IsaacNorris/new-stm32u3-203f-hardware/TODO.txt

add in pullups to the i2c logic.
remove all 1v8 logic and parts. 
add in resivour capacitors near the amplifier.

new stm32:
	https://www.digikey.com/en/products/detail/stmicroelectronics/STM32WB55CEU6/9919555
new dac:
	PCM5102a <- guaranteed works lol :)
	TAD5142
axeleromter:
	https://www.digikey.com.au/en/products/detail/stmicroelectronics/LSM6DSMTR/6192777
