IsaacNorris/new-stm32u3-203f-hardware/new-stm32u3-203f/new-stm32u3-203f.kicad_pcb

## KiCad design new-stm32u3-203f/new-stm32u3-203f.kicad_pcb (2026-02-23)

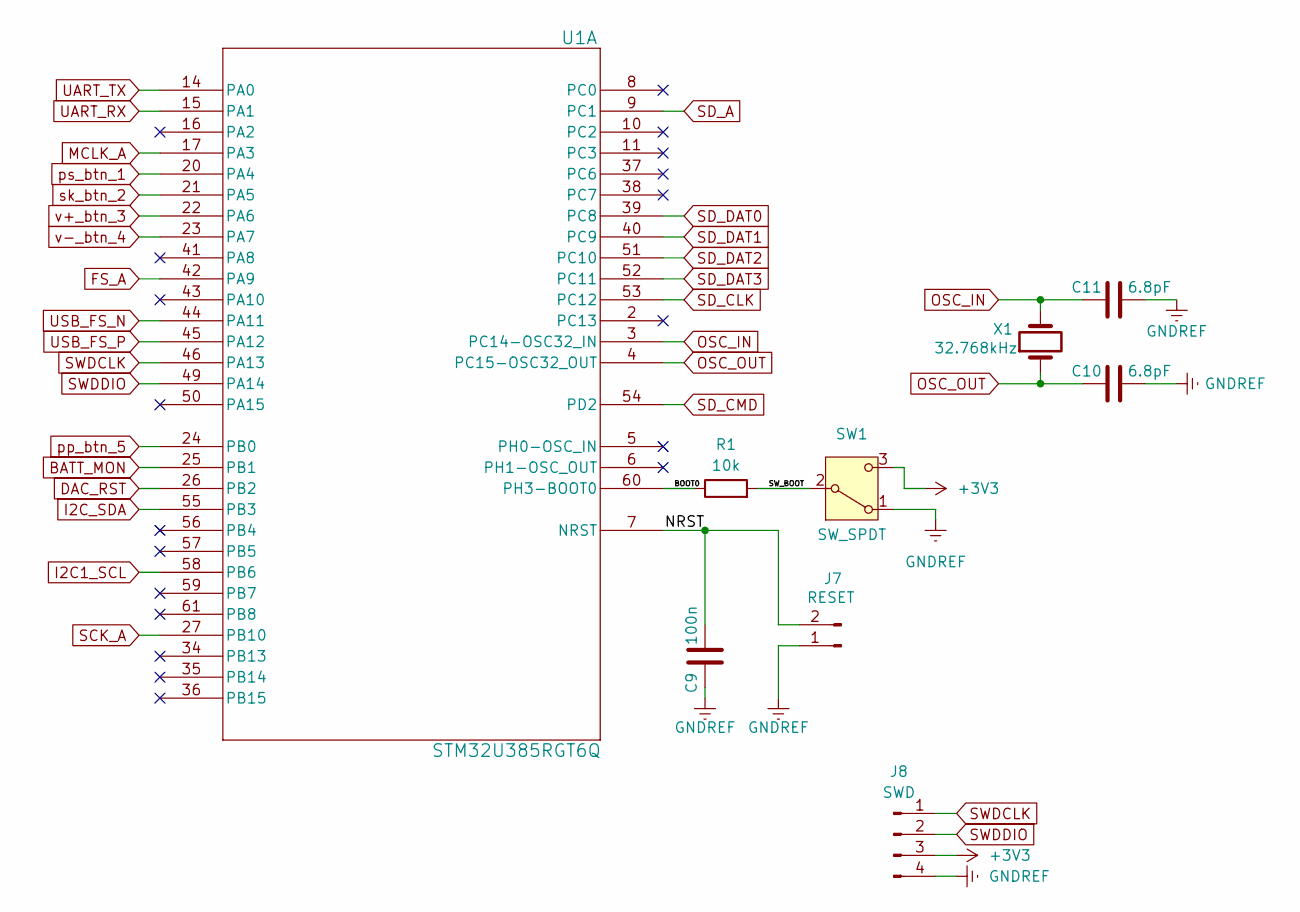
[picture p1: schematic new-stm32u3-203d-MCU_IO.kicad_sch]

Parts:
C9: 100n; C_0603_1608Metric
C10, C11: 6.8pF; C_0603_1608Metric
J7: RESET; PinHeader_1x02_P1.00mm_Vertical
J8: SWD; PinHeader_1x04_P2.54mm_Vertical
R1: 10k; R_0603_1608Metric
SW1: SW_SPDT; SW_CJS-1200TA
U1: STM32U385RGT6Q; LQFP-64_10x10mm_P0.5mm
X1: 32.768kHz; Crystal_SMD_3215-2Pin_3.2x1.5mm

Connections:
/MCU_IO/BOOT0: R1.1, U1.60 (PH3-BOOT0)
/MCU_IO/NRST: C9.2, J7.2, U1.7 (NRST)
/MCU_IO/SW_BOOT: R1.2, SW1.2 (B)
AVDD: J8.3, SW1.3 (C); also elsewhere on the board
BATT_MON: U1.25 (PB1); also elsewhere on the board
DAC_RST: U1.26 (PB2); also elsewhere on the board
FS_A: U1.42 (PA9); also elsewhere on the board
I2C1_SCL: U1.58 (PB6); also elsewhere on the board
I2C_SDA: U1.55 (PB3); also elsewhere on the board
MCLK_A: U1.17 (PA3); also elsewhere on the board
OSC_IN: C11.1, U1.3 (PC14-OSC32_IN), X1.2
OSC_OUT: C10.1, U1.4 (PC15-OSC32_OUT), X1.1
SCK_A: U1.27 (PB10); also elsewhere on the board
SD_A: U1.9 (PC1); also elsewhere on the board
SD_CLK: U1.53 (PC12); also elsewhere on the board
SD_CMD: U1.54 (PD2); also elsewhere on the board
SD_DAT0: U1.39 (PC8); also elsewhere on the board
SD_DAT1: U1.40 (PC9); also elsewhere on the board
SD_DAT2: U1.51 (PC10); also elsewhere on the board
SD_DAT3: U1.52 (PC11); also elsewhere on the board
SWDCLK: J8.1, U1.46 (PA13)
SWDDIO: J8.2, U1.49 (PA14)
UART_RX: U1.15 (PA1); also elsewhere on the board
UART_TX: U1.14 (PA0); also elsewhere on the board
UBS_D+: U1.45 (PA12); also elsewhere on the board
USB_D-: U1.44 (PA11); also elsewhere on the board
USB_GND: C9.1, C10.2, C11.2, J7.1, J8.4, SW1.1 (A); also elsewhere on the board
pp_btn_5: U1.24 (PB0); also elsewhere on the board
ps_btn_1: U1.20 (PA4); also elsewhere on the board
sk_btn_2: U1.21 (PA5); also elsewhere on the board
v+_btn_3: U1.22 (PA6); also elsewhere on the board
v-_btn_4: U1.23 (PA7); also elsewhere on the board

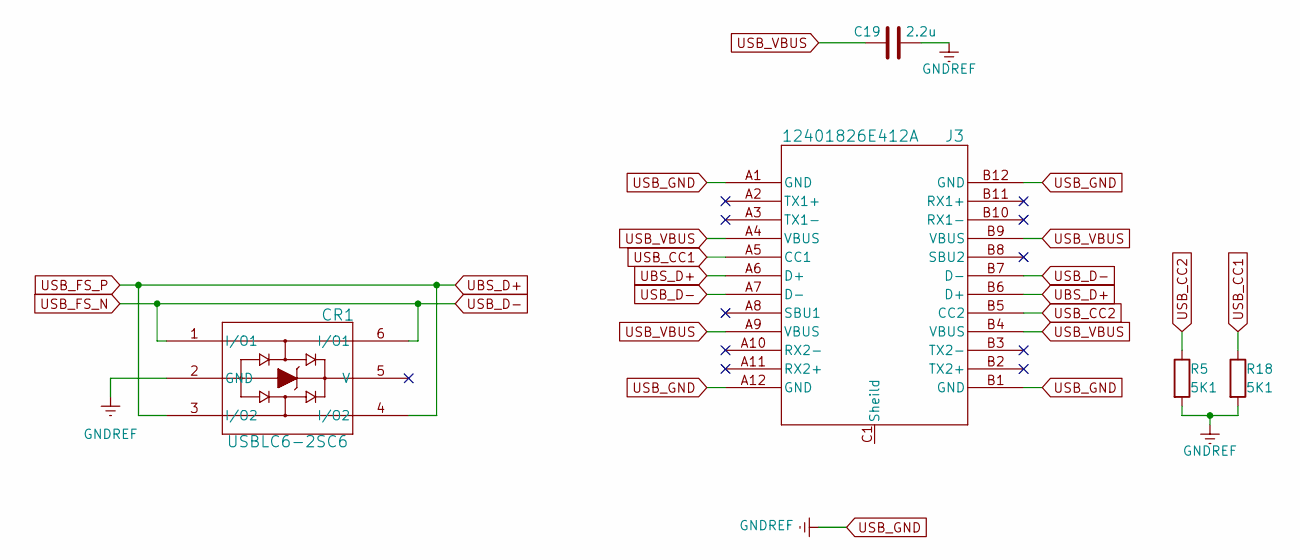
[picture p2: schematic new-stm32u3-203f-USB.kicad_sch]

Parts:
C19: 2.2u; C_0603_1608Metric
CR1: USBLC6-2SC6; SOT23-6L_STM
J3: 12401826E412A; 12401826_AMP
R5, R18: 5K1; R_0603_1608Metric

Connections:
UBS_D+: CR1.3 (I/O2), CR1.4 (I/O2), J3.A6 (D+), J3.B6 (D+); also elsewhere on the board
USB_3v3_EN: C19.1, J3.A4 (VBUS), J3.A9 (VBUS), J3.B4 (VBUS), J3.B9 (VBUS); also elsewhere on the board
USB_CC1: J3.A5 (CC1), R18.1
USB_CC2: J3.B5 (CC2), R5.1
USB_D-: CR1.1 (I/O1), CR1.6 (I/O1), J3.A7 (D-), J3.B7 (D-); also elsewhere on the board
USB_GND: C19.2, CR1.2 (GND), J3.A1 (GND), J3.A12 (GND), J3.B1 (GND), J3.B12 (GND), R5.2, R18.2; also elsewhere on the board

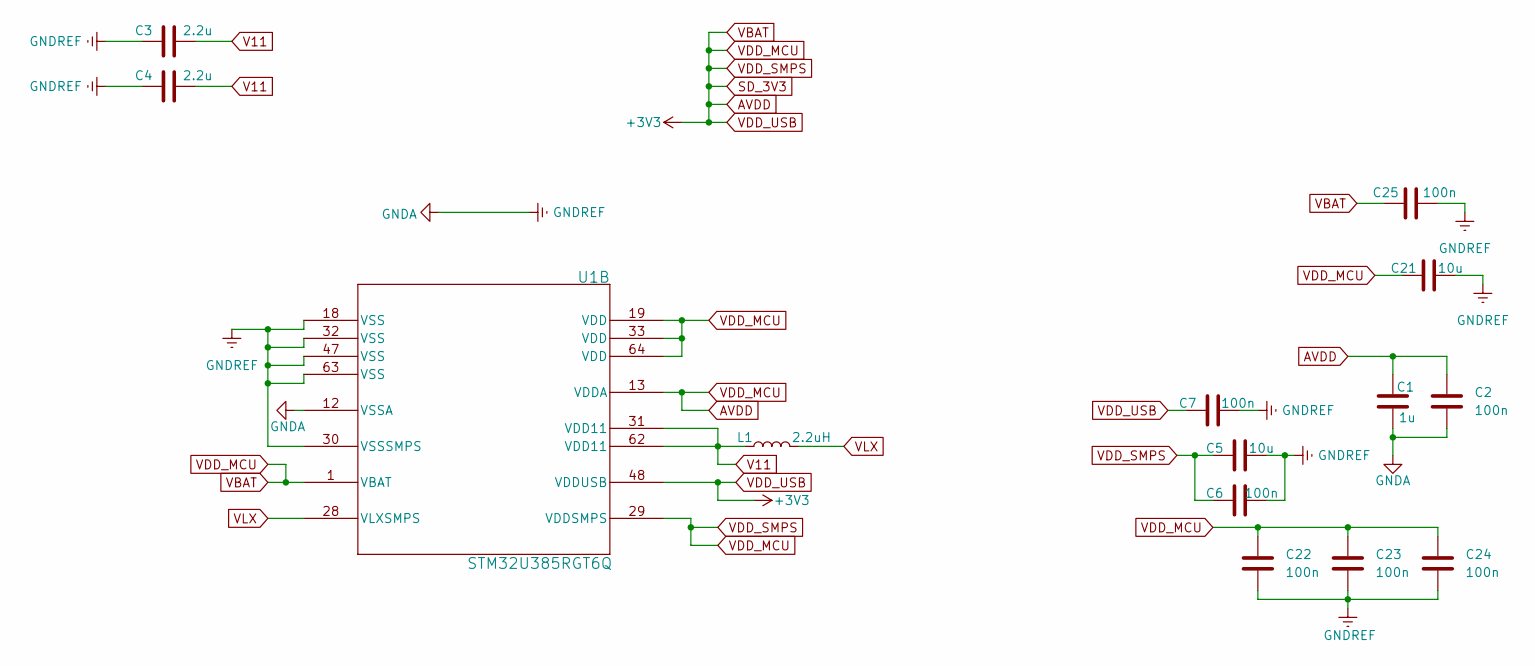
[picture p3: schematic new-stm32u3-203f-MCU_PWR.kicad_sch]

Parts:
C1: 1u; C_0603_1608Metric
C2, C6, C7, C22, C23, C24, C25: 100n; C_0603_1608Metric
C3, C4: 2.2u; C_0603_1608Metric
C5, C21: 10u; C_0603_1608Metric
L1: 2.2uH; L_0603_1608Metric
U1: STM32U385RGT6Q; LQFP-64_10x10mm_P0.5mm

Connections:
AVDD: C1.2, C2.2, C5.2, C6.2, C7.2, C21.2, C22.2, C23.2, C24.2, C25.2, U1.1 (VBAT), U1.13 (VDDA), U1.19 (VDD), U1.29 (VDDSMPS), U1.33 (VDD), U1.48 (VDDUSB), U1.64 (VDD); also elsewhere on the board
USB_GND: C1.1, C2.1, C3.2, C4.2, C5.1, C6.1, C7.1, C21.1, C22.1, C23.1, C24.1, C25.1, U1.12 (VSSA), U1.18 (VSS), U1.30 (VSSSMPS), U1.32 (VSS), U1.47 (VSS), U1.63 (VSS); also elsewhere on the board
V11: C3.1, C4.1, L1.1, U1.31 (VDD11), U1.62 (VDD11)
VLX: L1.2, U1.28 (VLXSMPS)

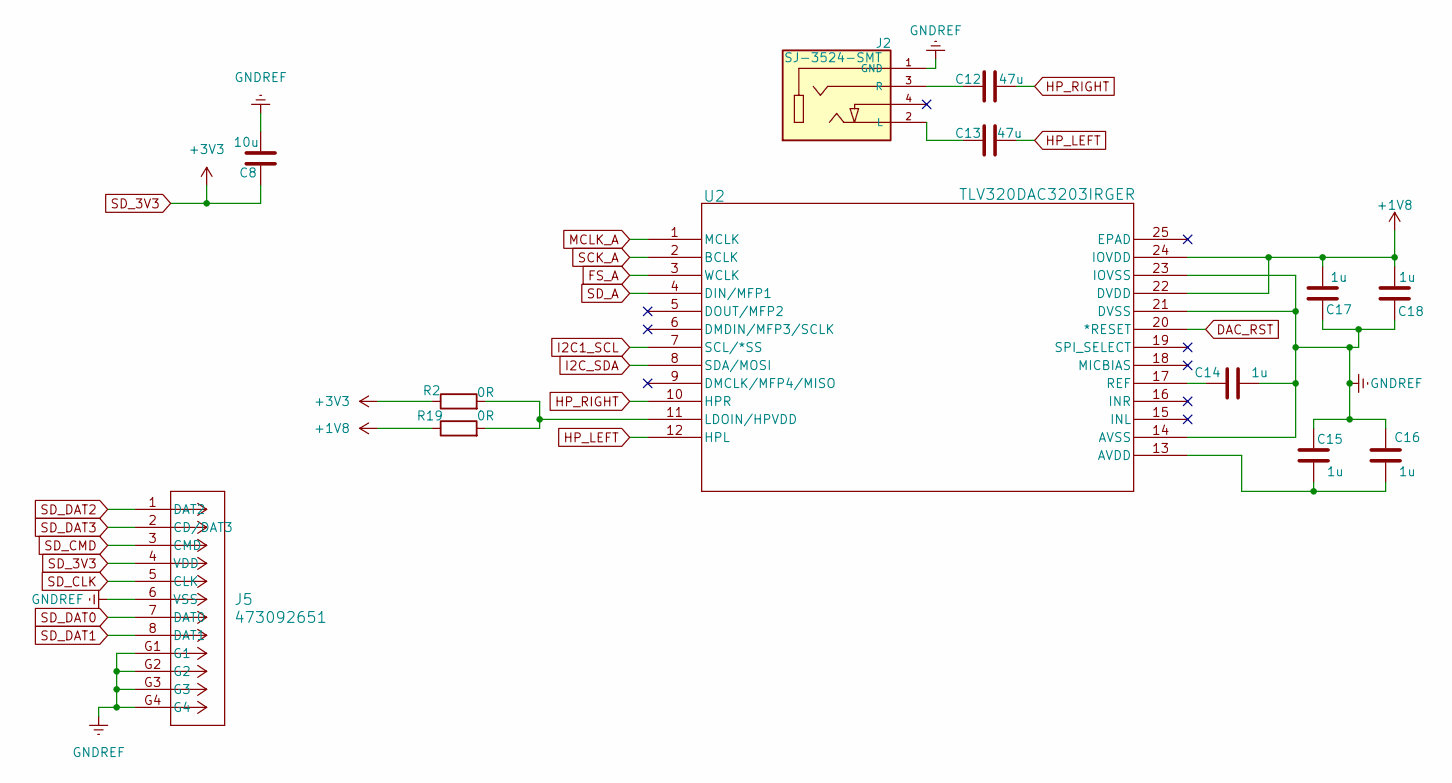
[picture p4: schematic new-stm32u3-203f-SD_DAC.kicad_sch]

Parts:
C8: 10u; C_0603_1608Metric
C12, C13: 47u; C_0603_1608Metric
C14, C15, C16, C17, C18: 1u; C_0603_1608Metric
J2: SJ-3524-SMT; Jack_3.5mm_CUI_SJ-3524-SMT_Horizontal; PARTREV 1.03
J5: 473092651; CONN12_47309-2651_MOL
R2, R19: 0R; R_0603_1608Metric
U2: TLV320DAC3203IRGER; Texas_RGE0024C_VQFN-24-1EP_4x4mm_P0.5mm_EP2.1x2.1mm

Connections:
+1V8: C17.2, C18.2, R19.1, U2.22 (DVDD), U2.24 (IOVDD); also elsewhere on the board
AVDD: C8.2, J5.4 (VDD), R2.1; also elsewhere on the board
DAC_RST: U2.20 (*RESET); also elsewhere on the board
FS_A: U2.3 (WCLK); also elsewhere on the board
HP_LEFT: C13.2, U2.12 (HPL)
HP_RIGHT: C12.2, U2.10 (HPR)
I2C1_SCL: U2.7 (SCL/*SS); also elsewhere on the board
I2C_SDA: U2.8 (SDA/MOSI); also elsewhere on the board
MCLK_A: U2.1 (MCLK); also elsewhere on the board
unnamed: C13.1, J2.2 (L), J2.T
unnamed: C12.1, J2.3 (R), J2.R
unnamed: C15.2, C16.2, U2.13 (AVDD)
unnamed: R2.2, R19.2, U2.11 (LDOIN/HPVDD)
unnamed: C14.1, U2.17 (REF)
SCK_A: U2.2 (BCLK); also elsewhere on the board
SD_A: U2.4 (DIN/MFP1); also elsewhere on the board
SD_CLK: J5.5 (CLK); also elsewhere on the board
SD_CMD: J5.3 (CMD); also elsewhere on the board
SD_DAT0: J5.7 (DAT0); also elsewhere on the board
SD_DAT1: J5.8 (DAT1); also elsewhere on the board
SD_DAT2: J5.1 (DAT2); also elsewhere on the board
SD_DAT3: J5.2 (CD/DAT3); also elsewhere on the board
USB_GND: C8.1, C14.2, C15.1, C16.1, C17.1, C18.1, J2.1 (GND), J2.S, J5.6 (VSS), J5.G1, J5.G2, J5.G3, J5.G4, U2.14 (AVSS), U2.21 (DVSS), U2.23 (IOVSS); also elsewhere on the board

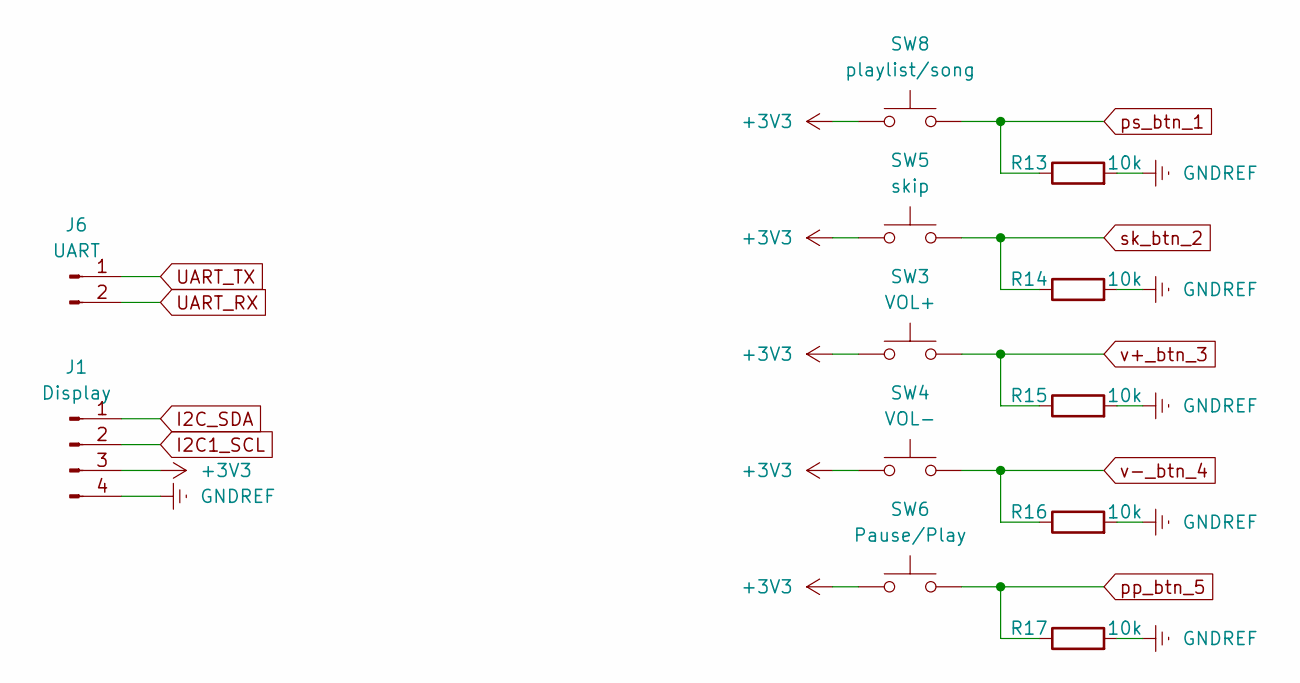
[picture p5: schematic new-stm32u3-203f-BASC_IO.kicad_sch]

Parts:
J1: Display; PinHeader_1x04_P2.54mm_Vertical
J6: UART; PinHeader_1x02_P2.54mm_Vertical
R13, R14, R15, R16, R17: 10k; R_0603_1608Metric
SW3: VOL+; Panasonic_EVQPUL_EVQPUC
SW4: VOL-; Panasonic_EVQPUL_EVQPUC
SW5: skip; Panasonic_EVQPUL_EVQPUC
SW6: Pause/Play; Panasonic_EVQPUL_EVQPUC
SW8: playlist/song; Panasonic_EVQPUL_EVQPUC

Connections:
AVDD: J1.3, SW3.1, SW4.1, SW5.1, SW6.1, SW8.1; also elsewhere on the board
I2C1_SCL: J1.2; also elsewhere on the board
I2C_SDA: J1.1; also elsewhere on the board
UART_RX: J6.2; also elsewhere on the board
UART_TX: J6.1; also elsewhere on the board
USB_GND: J1.4, R13.2, R14.2, R15.2, R16.2, R17.2; also elsewhere on the board
pp_btn_5: R17.1, SW6.2; also elsewhere on the board
ps_btn_1: R13.1, SW8.2; also elsewhere on the board
sk_btn_2: R14.1, SW5.2; also elsewhere on the board
v+_btn_3: R15.1, SW3.2; also elsewhere on the board
v-_btn_4: R16.1, SW4.2; also elsewhere on the board

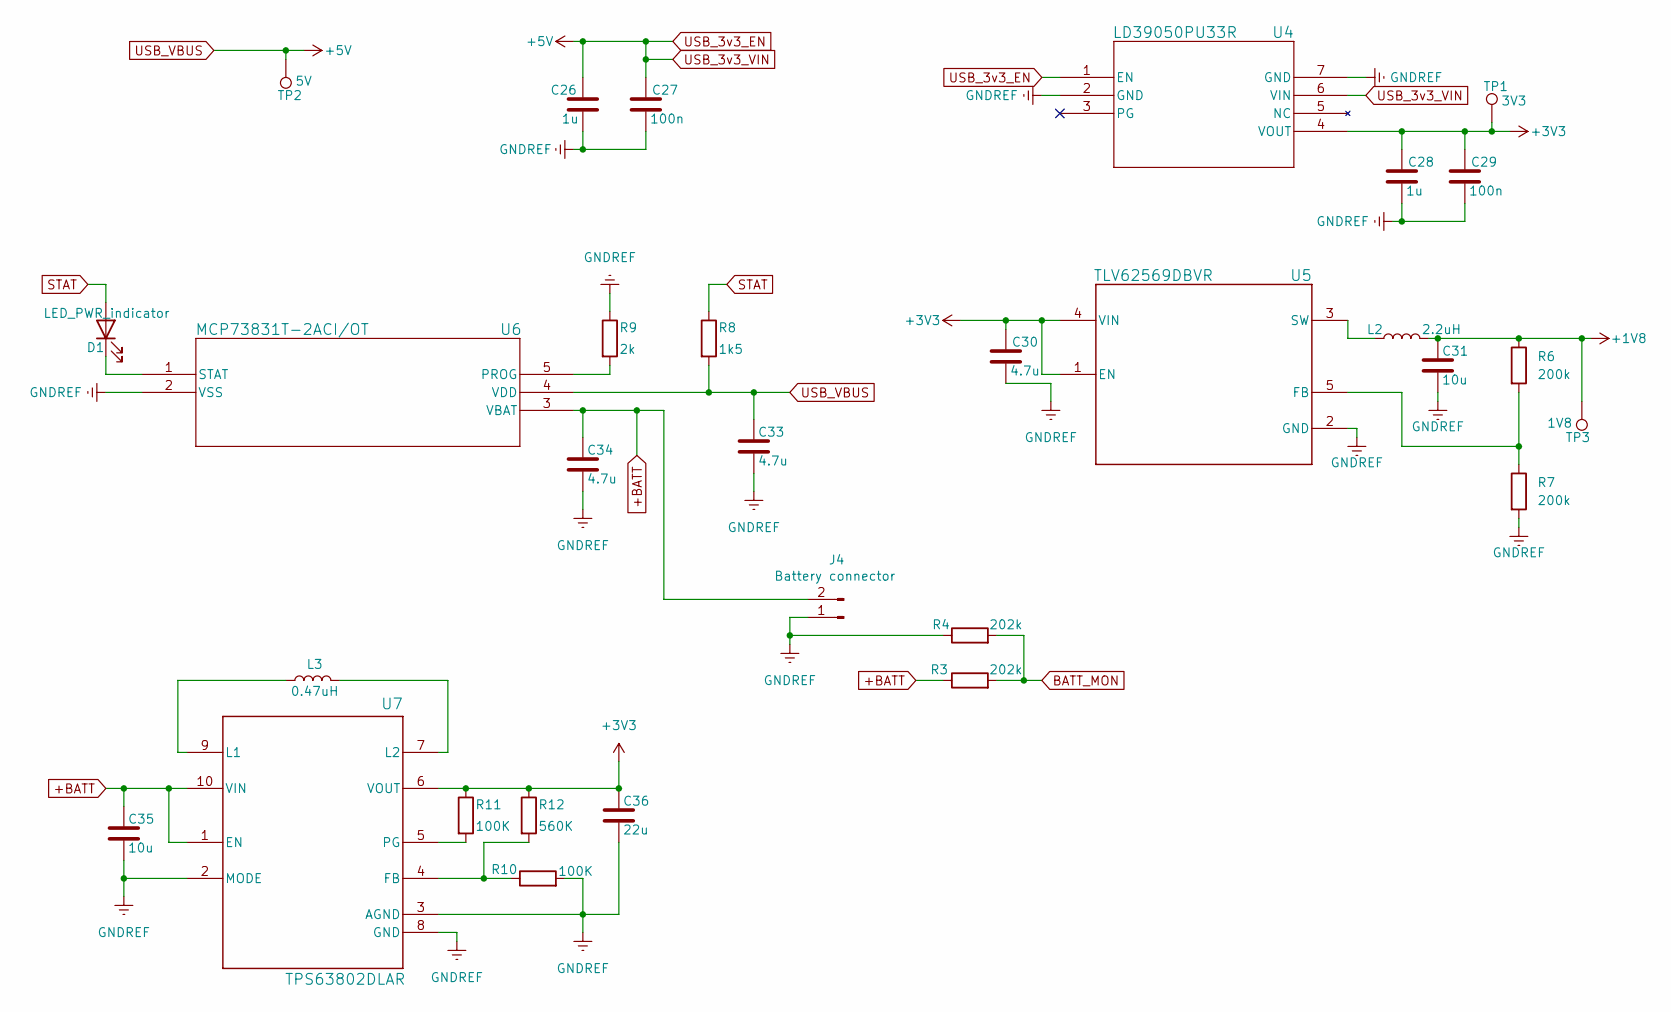
[picture p6: schematic new-stm32u3-203f-POWER.kicad_sch]

Parts:
C26, C28: 1u; C_0603_1608Metric
C27, C29: 100n; C_0603_1608Metric
C30, C33, C34: 4.7u; C_0603_1608Metric
C31, C35: 10u; C_0603_1608Metric
C36: 22u; C_0603_1608Metric
D1: LED_PWR_indicator; LED_0603_1608Metric
J4: Battery connector; PinHeader_1x02_P2.54mm_Vertical
L2: 2.2uH; L_0603_1608Metric
L3: 0.47uH; L_0603_1608Metric
R3, R4: 202k; R_0603_1608Metric
R6, R7: 200k; R_0603_1608Metric
R8: 1k5; R_0603_1608Metric
R9: 2k; R_0603_1608Metric
R10, R11: 100K; R_0603_1608Metric
R12: 560K; R_0603_1608Metric
TP1: 3V3; TestPoint_Pad_D1.0mm
TP2: 5V; TestPoint_Pad_D1.0mm
TP3: 1V8; TestPoint_Pad_D1.0mm
U4: LD39050PU33R; DFN-6-1EP_3x3mm_P0.95mm_EP1.7x2.6mm
U5: TLV62569DBVR; SOT-23-5
U6: MCP73831T-2ACI/OT; SOT-23-5
U7: TPS63802DLAR; DLA0010A

Connections:
+1V8: C31.2, L2.2, R6.1, TP3.1; also elsewhere on the board
+BATT: C34.2, C35.2, J4.2, R3.1, U6.3 (VBAT), U7.1 (EN), U7.10 (VIN)
AVDD: C28.2, C29.2, C30.2, C36.2, R11.1, R12.1, TP1.1, U4.4 (VOUT), U5.1 (EN), U5.4 (VIN), U7.6 (VOUT); also elsewhere on the board
BATT_MON: R3.2, R4.2; also elsewhere on the board
unnamed: D1.1 (K), U6.1 (STAT)
unnamed: R6.2, R7.1, U5.5 (FB)
unnamed: L2.1, U5.3 (SW)
unnamed: R9.2, U6.5 (PROG)
unnamed: R10.1, R12.2, U7.4 (FB)
unnamed: L3.1, U7.9 (L1)
unnamed: L3.2, U7.7 (L2)
unnamed: R11.2, U7.5 (PG)
STAT: D1.2 (A), R8.1
USB_3v3_EN: C26.2, C27.2, C33.2, R8.2, TP2.1, U4.1 (EN), U4.6 (VIN), U6.4 (VDD); also elsewhere on the board
USB_GND: C26.1, C27.1, C28.1, C29.1, C30.1, C31.1, C33.1, C34.1, C35.1, C36.1, J4.1, R4.1, R7.2, R9.1, R10.2, U4.2 (GND), U4.7 (GND), U5.2 (GND), U6.2 (VSS), U7.2 (MODE), U7.3 (AGND), U7.8 (GND); also elsewhere on the board

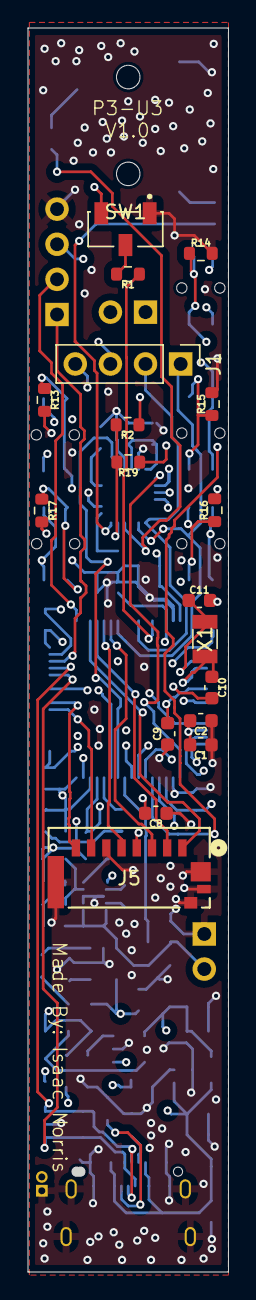
[picture p7: board new-stm32u3-203f.kicad_pcb from above]

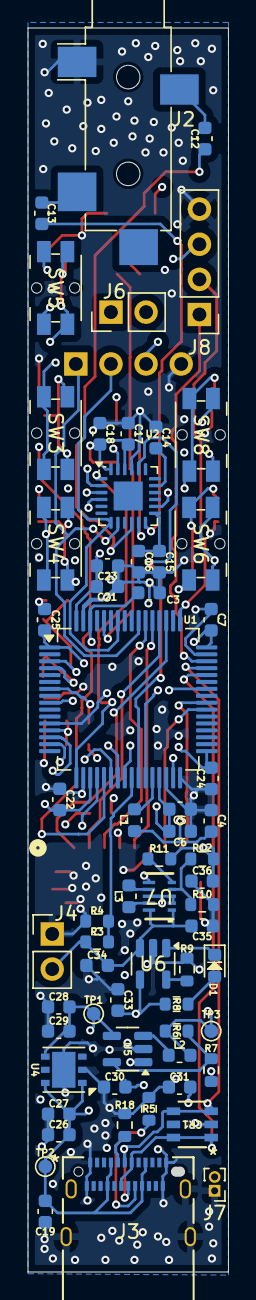
[picture p8: board new-stm32u3-203f.kicad_pcb from below]

Board: 6 copper layers, 14.5 x 90.0 mm, 82 parts (64 on the bottom side), 55 nets.
