IsaacNorris/new-stm32u3-203f-hardware/new-stm32u3-203f-hardware.ioc

Mcu.UserName=STM32U385RGTxQ
PA0.Signal=UART4_TX
PA1.Signal=UART4_RX
PA11.Signal=USB_DM
PA12.Signal=USB_DP
PA3.Signal=SAI1_MCLK_A
PA4.Signal=GPIO_Input
PA5.Signal=GPIO_Input
PA6.Signal=GPIO_Input
PA7.Signal=GPIO_Input
PA9.Signal=SAI1_FS_A
PB0.Signal=GPIO_Input
PB1.Signal=ADC1_IN14
PB10.Signal=SAI1_SCK_A
PB2.Signal=GPIO_Output
PB6.Signal=I2C1_SCL
PB7.Signal=I2C1_SDA
PC10.Signal=SDMMC1_D2
PC11.Signal=SDMMC1_D3
PC12.Signal=SDMMC1_CK
PC3.Signal=SAI1_SD_A
PC8.Signal=SDMMC1_D0
PC9.Signal=SDMMC1_D1
PD2.Signal=SDMMC1_CMD
