IsaacNorris/new-stm32u3-203f-hardware/(commit log)

2026-01-22 initialised the repo
    [new-stm32u3-203f.kicad_pcb, new-stm32u3-203f.kicad_sch, new-stm32u3-203f_temp_bak.kicad_sch]
2026-01-23 removed bad temp file
    [new-stm32u3-203f_temp_bak.kicad_sch]
2026-01-23 added some usb stuff, changed to 64 pinout.
    [new-stm32u3-203f.kicad_sch, untitled.kicad_sch]
2026-01-24 mcu power finished
    [new-stm32u3-203f.kicad_sch]
2026-01-24 finished the sd card wiring up.
    [new-stm32u3-203f.kicad_sch]
2026-01-24 made some prograss on the usb/power stuff.
    [new-stm32u3-203f.kicad_sch]
2026-01-25 made some progress on the board.
    [new-stm32u3-203f.kicad_sch]
2026-01-26 finished the USB page of the eval board. now need to do power for 3v3, 5v, & 1v8
    [new-stm32u3-203f.kicad_sch]
2026-01-26 added 1v8 power
    [new-stm32u3-203f.kicad_sch]
2026-01-26 moved some studd around.
    [new-stm32u3-203f.kicad_sch]
2026-01-27 did the power pins
    [new-stm32u3-203f.kicad_sch]
2026-01-27 moved sections to their own sheets. much cleaner now :)
    [new-stm32u3-203d-MCU_IO.kicad_sch, new-stm32u3-203f-BASC_IO.kicad_sch, new-stm32u3-203f-MCU_PWR.kicad_sch, new-stm32u3-203f-POWER.kicad_sch, new-stm32u3-203f-SD_DAC.kicad_sch, new-stm32u3-203f-USB.kicad_sch, new-stm32u3-203f.kicad_sch]
2026-01-27 added battery charging circuit
    [new-stm32u3-203f-POWER.kicad_sch, new-stm32u3-203f.kicad_sch]
2026-01-28 moved over to new sd card stuff
    [new-stm32u3-203f-SD_DAC.kicad_sch]
2026-01-28 added buttons, added uart, added display.
    [new-stm32u3-203d-MCU_IO.kicad_sch, new-stm32u3-203f-BASC_IO.kicad_sch, new-stm32u3-203f.kicad_sch]
2026-01-29 finished the schematic, just need someone to review it :)
    [new-stm32u3-203d-MCU_IO.kicad_sch, new-stm32u3-203f-POWER.kicad_sch, new-stm32u3-203f-SD_DAC.kicad_sch, new-stm32u3-203f.kicad_sch]
2026-01-30 added reset button. asigned footprints.
    [new-stm32u3-203d-MCU_IO.kicad_sch, new-stm32u3-203f-BASC_IO.kicad_sch, new-stm32u3-203f-MCU_PWR.kicad_sch, new-stm32u3-203f-POWER.kicad_sch, new-stm32u3-203f-SD_DAC.kicad_sch, new-stm32u3-203f-USB.kicad_sch]
2026-01-30 made some progress on the pcb
    [new-stm32u3-203d-MCU_IO.kicad_sch, new-stm32u3-203f-BASC_IO.kicad_sch, new-stm32u3-203f-POWER.kicad_sch, new-stm32u3-203f-SD_DAC.kicad_sch, new-stm32u3-203f.kicad_pcb]
2026-01-31 made some progress on the pcb layout
    [new-stm32u3-203f.kicad_pcb]
2026-02-01 made some progress witht he layout.
    [new-stm32u3-203f-POWER.kicad_sch, new-stm32u3-203f.kicad_pcb]
2026-02-02 moved over to just using direct usb 2.0, made progress on pcb layout
    [new-stm32u3-203d-MCU_IO.kicad_sch, new-stm32u3-203f-POWER.kicad_sch, new-stm32u3-203f-USB.kicad_sch, new-stm32u3-203f.kicad_pcb]
2026-02-02 finished the layout of the pcb
    [new-stm32u3-203d-MCU_IO.kicad_sch, new-stm32u3-203f-MCU_PWR.kicad_sch, new-stm32u3-203f-POWER.kicad_sch, new-stm32u3-203f.kicad_pcb]
2026-02-03 made some progress on layout and routes.
    [new-stm32u3-203f.kicad_pcb]
2026-02-04 added in 0r to choose ldoin of dac
    [new-stm32u3-203f-SD_DAC.kicad_sch, new-stm32u3-203f.csv, new-stm32u3-203f.kicad_pcb]
2026-02-04 made routing progress
    [new-stm32u3-203f-SD_DAC.kicad_sch, new-stm32u3-203f.kicad_pcb]
2026-02-04 made some better progress routing
    [new-stm32u3-203d-MCU_IO.kicad_sch, new-stm32u3-203f-POWER.kicad_sch, new-stm32u3-203f-SD_DAC.kicad_sch, new-stm32u3-203f.kicad_pcb]
2026-02-05 restarted routing and started using 6 layers and power planes.
    [new-stm32u3-203d-MCU_IO.kicad_sch, new-stm32u3-203f-USB.kicad_sch, new-stm32u3-203f.kicad_pcb]
2026-02-05 finished routing, need angus to check
    [new-stm32u3-203f.kicad_pcb]
2026-02-06 ficxed all the vias and some routing, will need to add in ground stitching
    [new-stm32u3-203f.kicad_pcb]
2026-02-10 added usb sheilding and more stiching vias
    [new-stm32u3-203f.kicad_pcb]
2026-02-12 fixed silkscreen.
    [new-stm32u3-203f.csv, new-stm32u3-203f.kicad_pcb]
2026-02-20 fixed some of the drc erros will need to complete more.
    [new-stm32u3-203f.kicad_pcb]
2026-02-20 finished more errors, started adding extra stuff.
    [new-stm32u3-203f-USB.kicad_sch, new-stm32u3-203f.kicad_pcb]
2026-02-20 fixed drc and some other things.
    [new-stm32u3-203f-USB.kicad_sch, new-stm32u3-203f.kicad_pcb]
2026-02-23 did some hardware fixes.
    [new-stm32u3-203f-B_Cu.gbr, new-stm32u3-203f-B_Mask.gbr, new-stm32u3-203f-B_Paste.gbr, new-stm32u3-203f-B_Silkscreen.gbr, new-stm32u3-203f-Edge_Cuts.gbr, new-stm32u3-203f-F_Cu.gbr, new-stm32u3-203f-F_Mask.gbr, new-stm32u3-203f-F_Paste.gbr]
2026-08-07 added in the backups i guess.
    [test_ccg.kicad_pcb, test_ccg.kicad_sch]
2026-08-19 added new stm32
